asliwaa/ECG-Holter/hardware/holter_monitor.kicad_pcb

## KiCad design hardware/holter_monitor.kicad_pcb (2026-11-06)

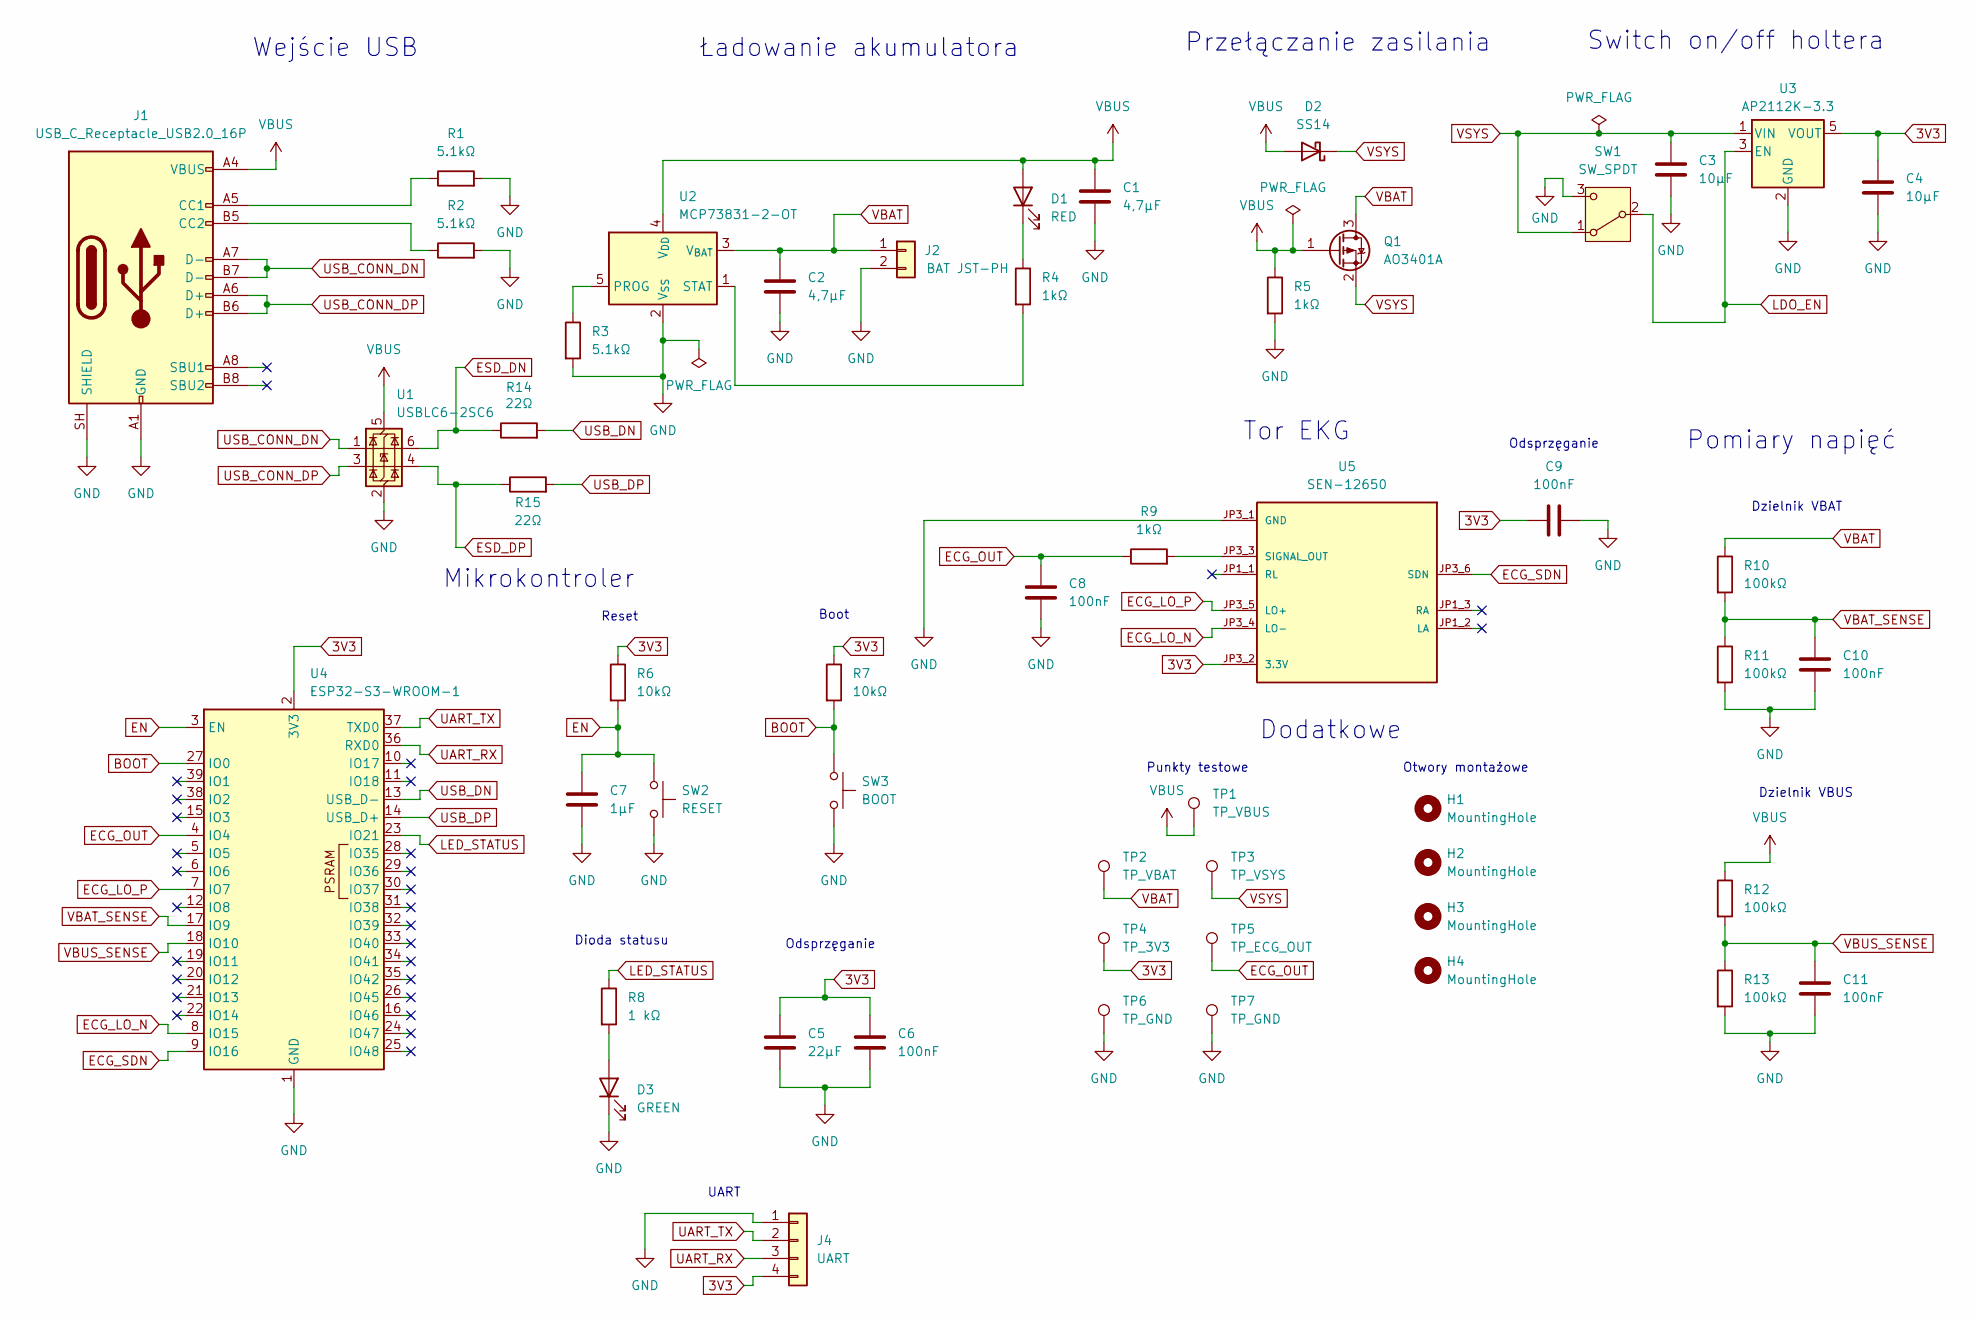
[picture p1: schematic holter_monitor.kicad_sch, Remote ECG signal monitoring system]

Parts:
C1, C2: 4,7µF; C_0805_2012Metric_Pad1.18x1.45mm_HandSolder
C3, C4: 10µF; C_0805_2012Metric_Pad1.18x1.45mm_HandSolder
C5: 22µF; C_0805_2012Metric_Pad1.18x1.45mm_HandSolder
C6, C8, C9, C10, C11: 100nF; C_0805_2012Metric_Pad1.18x1.45mm_HandSolder
C7: 1µF; C_0805_2012Metric_Pad1.18x1.45mm_HandSolder
D1: RED; LED_0805_2012Metric_Pad1.15x1.40mm_HandSolder
D2: SS14; D_SMA_Handsoldering
D3: GREEN; LED_0805_2012Metric_Pad1.15x1.40mm_HandSolder
H1, H2, H3, H4: MountingHole; MountingHole_3.2mm_M3
J1: USB_C_Receptacle_USB2.0_16P; USB_C_Receptacle_GCT_USB4105-xx-A_16P_TopMnt_Horizontal
J2: BAT JST-PH; JST_PH_S2B-PH-K_1x02_P2.00mm_Horizontal
J4: UART; PinHeader_1x04_P2.54mm_Vertical
Q1: AO3401A; SOT-23_Handsoldering
R1, R2, R3: 5.1kΩ; R_0805_2012Metric_Pad1.20x1.40mm_HandSolder
R4, R5, R9: 1kΩ; R_0805_2012Metric_Pad1.20x1.40mm_HandSolder
R6, R7: 10kΩ; R_0805_2012Metric_Pad1.20x1.40mm_HandSolder
R8: 1 kΩ; R_0805_2012Metric_Pad1.20x1.40mm_HandSolder
R10, R11, R12, R13: 100kΩ; R_0805_2012Metric_Pad1.20x1.40mm_HandSolder
R14, R15: 22Ω; R_0805_2012Metric_Pad1.20x1.40mm_HandSolder
SW1: SW_SPDT; SW_Slide_SPDT_Straight_CK_OS102011MS2Q
SW2: RESET; SW_SPST_TL3342
SW3: BOOT; SW_SPST_TL3342
TP1: TP_VBUS; TestPoint_Pad_D1.5mm
TP2: TP_VBAT; TestPoint_Pad_D1.5mm
TP3: TP_VSYS; TestPoint_Pad_D1.5mm
TP4: TP_3V3; TestPoint_Pad_D1.5mm
TP5: TP_ECG_OUT; TestPoint_Pad_D1.5mm
TP6, TP7: TP_GND; TestPoint_Pad_D1.5mm
U1: USBLC6-2SC6; SOT-23-6_Handsoldering
U2: MCP73831-2-OT; SOT-23-5_HandSoldering
U3: AP2112K-3.3; SOT-23-5_HandSoldering
U4: ESP32-S3-WROOM-1
U5: SEN-12650; MODULE_SEN-12650; PARTREV V10

Connections:
3V3: C4.1, C5.1, C6.1, C9.1, J4.4, R6.1, R7.1, TP4.1 (1_1), U3.5 (VOUT), U4.2 (3V3), U5.JP3_2 (3.3V)
BOOT: R7.2, SW3.1, U4.27 (IO0)
ECG_LO_N: U4.8 (IO15), U5.JP3_4 (LO-)
ECG_LO_P: U4.7 (IO7), U5.JP3_5 (LO+)
ECG_OUT: C8.1, R9.1, TP5.1 (1_1), U4.4 (IO4)
ECG_SDN: U4.9 (IO16), U5.JP3_6 (SDN)
EN: C7.1, R6.2, SW2.1, U4.3 (EN)
ESD_DN: R14.1, U1.6 (I/O1)
ESD_DP: R15.1, U1.4 (I/O2)
GND: C1.2, C2.2, C3.2, C4.2, C5.2, C6.2, C7.2, C8.2, C9.2, C10.2, C11.2, D3.1 (K), J1.A1 (GND), J1.A12 (GND), J1.B1 (GND), J1.B12 (GND), J1.SH (SHIELD), J2.2, J4.1, R1.2, R2.2, R3.2, R5.2, R11.2, R13.2, SW1.3 (C), SW2.2, SW3.2, TP6.1 (1_1), TP7.1 (1_1), U1.2 (GND), U2.2 (V_{SS}), U3.2 (GND), U4.1 (GND), U4.40 (GND), U4.41 (GND), U5.JP3_1 (GND)
LDO_EN: SW1.2 (B), U3.3 (EN)
LED_STATUS: R8.1, U4.23 (IO21)
unnamed: D1.1 (K), R4.1
unnamed: D3.2 (A), R8.2
unnamed: J1.A5 (CC1), R1.1
unnamed: J1.B5 (CC2), R2.1
unnamed: R3.1, U2.5 (PROG)
unnamed: R4.2, U2.1 (STAT)
unnamed: R9.2, U5.JP3_3 (SIGNAL_OUT)
UART_RX: J4.3, U4.36 (RXD0)
UART_TX: J4.2, U4.37 (TXD0)
USB_CONN_DN: J1.A7 (D-), J1.B7 (D-), U1.1 (I/O1)
USB_CONN_DP: J1.A6 (D+), J1.B6 (D+), U1.3 (I/O2)
USB_DN: R14.2, U4.13 (USB_D-)
USB_DP: R15.2, U4.14 (USB_D+)
VBAT: C2.1, J2.1, Q1.3 (D), R10.1, TP2.1 (1_1), U2.3 (V_{BAT})
VBAT_SENSE: C10.1, R10.2, R11.1, U4.17 (IO9)
VBUS: C1.1, D1.2 (A), D2.2 (A), J1.A4 (VBUS), J1.A9 (VBUS), J1.B4 (VBUS), J1.B9 (VBUS), Q1.1 (G), R5.1, R12.1, TP1.1 (1_1), U1.5 (VBUS), U2.4 (V_{DD})
VBUS_SENSE: C11.1, R12.2, R13.1, U4.18 (IO10)
VSYS: C3.1, D2.1 (K), Q1.2 (S), SW1.1 (A), TP3.1 (1_1), U3.1 (VIN)

Notes on the sheet:
Dzielnik VBAT
Boot
Reset
Odsprzęganie
Switch on/off holtera
UART
Przełączanie zasilania
Wejście USB
Dzielnik VBUS
Dioda statusu
Punkty testowe
Pomiary napięć
Ładowanie akumulatora
Dodatkowe
Otwory montażowe
Mikrokontroler
Tor EKG

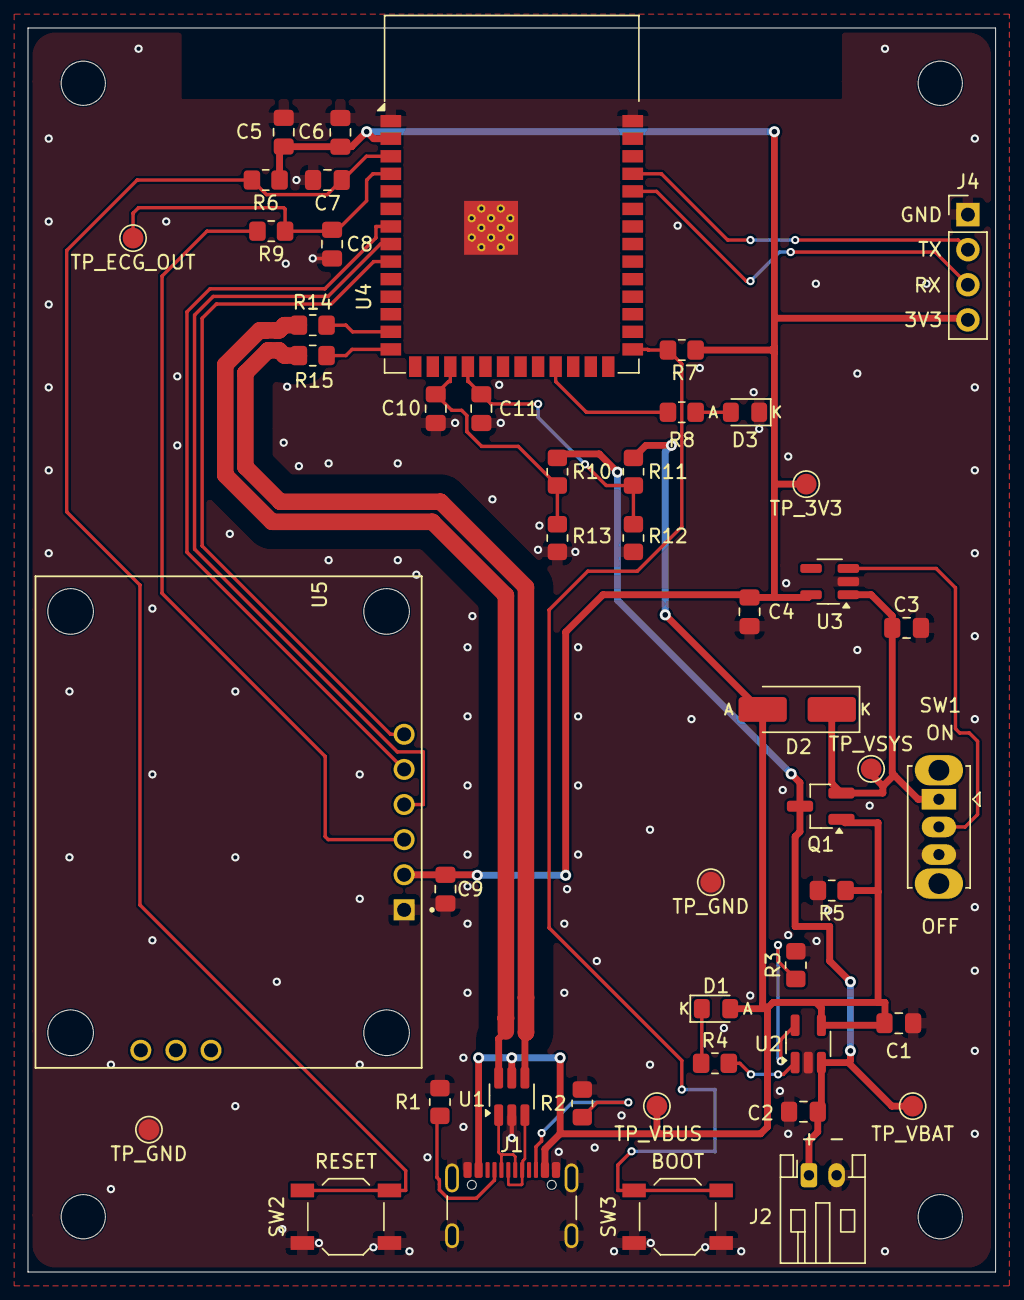
[picture p2: board holter_monitor.kicad_pcb from above]

Board: 2 copper layers, 70.0 x 90.0 mm, 52 parts (0 on the bottom side), 30 nets.
