asliwaa/ECG-Holter/(commit log)

2026-10-10 Add README, .gitignore and initial KiCad schematic
2026-10-10 Add all elements to KiCad schematic
2026-10-11 Added connections: USB, battery, charging switch, on/off switch, ESP-32-S3, ECG
2026-10-11 Added power flags, resistors and capacitor, fixed erc check fails
2026-10-13 Added VSW label to the schematic
2026-10-13 Placed footprints in the pcb design file, added edge cuts
2026-10-13 Switched from just the AD8232 symbol to full SEN-12650 module symbol
2026-10-13 Switched from AD8232 footprint to complete SEN-12650 module footprint
2026-10-14 Added switches, uart and battery pins to the pcb design
2026-10-14 Switched VBAT and VBUS SENSE labels in ESP32-S3 from IO5/6 to IO9/10 to have more space
2026-10-14 Placed all of the elements on the board
2026-10-21 Adjust placements of resistors and capacitors
2026-11-03 Lines D+ and D- are now approximatelly the same length, GND point are now cross-shaped for easier soldering
2026-11-03 Added katode and anode marks for diodes
2026-11-03 Schematic and PCB design v1.0
2026-11-06 Added 67 ground vias and optimized USB differential routing
