asliwaa/ECG-Holter/(notices)

Notices in the files:
README.md:
License: MIT / CERN-OHL-S
